mmvlasaty/HEHS_ROV_2018/README.md

# HEHS_ROV_2018

Control system repository for the HEHS 2018 MATE ROV competition team.
