mmvlasaty/HEHS_ROV_2018/Notes/Firmata.rtf

Instructions for modifying Firmata

Arduino Firmata Ethernet Setup

W5200 Drivers

https://github.com/Seeed-Studio/Ethernet_Shield_W5200

Remove Ethernet Directory from Arduino IDE Library.

Import W5200 Ethernet Drivers into Arduino IDE

Install Sample PrimaryFirmataEthernet

Save PrimaryFirmataEthernet sketch

Open ethernetConfig.h, add W5200 Library, comment out Ethernet.h line, change the remote IP to 192.168.0.xx (server’s IP address) and change local_IP to 192.168.0.177.

Navigate to Arduino/libraries/Firmata/Utility/EthernetServerStream.h and edit it with a text editor. When it opens, edit #include <Ethernet.h> to #include <EthernetV2_0.h> and save the file.

W5200 on Arduino

https://nathan.chantrell.net/20120811/using-the-atmega1284p-with-the-arduino-ide-wiz820io/

WIZ820IO needs a reset signal to be enabled by standalone atmega328p

From: https://forum.pjrc.com/threads/41958-Ethernet-begin-hangs-after-power-cyle-in-Nov-29-2016-release

Add the following before Ethernet.begin() in void initTransport() of StandardFirmataEthernet

pinMode(PIN_TO_DIGITAL(7), OUTPUT); // switch off SD card bypassing Firmata
digitalWrite(PIN_TO_DIGITAL(7), LOW); // WIZ820io RESET is active low;
delay(250); // need atleast 2us low
digitalWrite(PIN_TO_DIGITAL(7), HIGH); // Release WIZ820io Reset
delay(500); // need atleast 150ms low

Save the sketch, build and run.

BlueESC Python Control: https://www.youtube.com/watch?v=Ecfi71G2Hq4

https://www.dropbox.com/sh/btfzhd3q2ox37uf/AAB-JFvWSD_Um9bVl_S_k9vya?dl=0

USE I2C Scanner to find BlueESC addresses.

Explanation of using Pymata

http://www.instructables.com/id/Going-Beyond-StandardFirmata-Adding-New-Device-Sup/

Example code for controlling BlueESC over Ethernet

#!/usr/bin/python

from pymata_aio.pymata3 import PyMata3
from pymata_aio.constants import Constants

BOARD_LED = 8
board = PyMata3(ip_address = '192.168.0.177', ip_port=3030, ip_handshake='') # IP address of StandardFirmataEthernet and port

# I2c address of the motor controllers "0x29" = 41 is the default

DEVICE0_ADDRESS = 41
DEVICE1_ADDRESS = 42
DEVICE2_ADDRESS = 43

# I2c register of the throttle (it is 16 bit/2 byte so treat it like a "word")

THROTTLE0 = 6000 # max value = 32000
THROTTLE1 = 6000
THROTTLE2 = 6000

def setup():
# board.set_pin_mode(BOARD_LED, Constants.OUTPUT)

# configure firmata for i2c on an UNO

board.i2c_config(0)

def loop():
# print("LED On")

# board.digital_write(BOARD_LED, 1)

# board.sleep(1.0)

TEMP = 0x02
#The temperature's I2c register (it's 2 bytes 0x06 and 0x07)

# print("Is the BlueESC Alive?")

# print(board.i2c_read_request(DEVICE_ADDRESS, TEMP, 9, Constants.I2C_READ))

# print("Probably not in a real unit...")

# board.sleep(1.0)

print("initialize the motor")
board.i2c_write_request(DEVICE0_ADDRESS, [0, 0, 0]) #send 0, 0, 0 to arm the controller
board.i2c_write_request(DEVICE1_ADDRESS, [0, 0, 0])
board.i2c_write_request(DEVICE2_ADDRESS, [0, 0, 0])
board.sleep(2.0)
board.i2c_write_request(DEVICE0_ADDRESS, [0, -THROTTLE0>>8, -THROTTLE0]) #send (0, value>>8, value) to send (throttle command, high byte, low byte)
board.i2c_write_request(DEVICE1_ADDRESS, [0, -THROTTLE1>>8, -THROTTLE1])
board.i2c_write_request(DEVICE2_ADDRESS, [0, -THROTTLE2>>8, -THROTTLE2])
# board.i2c_write_request(DEVICE_ADDRESS, [0x00 | 0x00 | 0x00])

board.sleep(2.0)

print("turn on the motor forward")
board.i2c_write_request(DEVICE0_ADDRESS, [0, 0, 0])
board.i2c_write_request(DEVICE1_ADDRESS, [0, 0, 0])
board.i2c_write_request(DEVICE2_ADDRESS, [0, 0, 0])
board.sleep(2.0)
board.i2c_write_request(DEVICE0_ADDRESS, [0, THROTTLE0>>8, THROTTLE0])
board.i2c_write_request(DEVICE1_ADDRESS, [0, THROTTLE1>>8, THROTTLE1])
board.i2c_write_request(DEVICE2_ADDRESS, [0, THROTTLE2>>8, THROTTLE2])
board.sleep(2)

if __name__ == "__main__":
setup()
while True:
loop()

Add Ping to StandardFirmataEthernet

https://github.com/MrYsLab/pymata-aio/wiki/Uploading-FirmataPlus-to-Arduino

Copy all ping related code from Firmata plus found here: https://github.com/MrYsLab/pymata-aio/tree/master/FirmataPlus

Retrieve data from ping sensor: https://github.com/MrYsLab/pymata-aio/blob/master/test/ping.py
