mmvlasaty/HEHS_ROV_2018/(list of files, cad)

Other CAD files:
ATmega/tgy-bluesc/tp_nfet.obj
ATmega/tgy-bluesc/arctictiger.obj
ATmega/tgy-bluesc/tgy.obj
ATmega/tgy-bluesc/dlu40a.obj
ATmega/tgy-bluesc/tp_8khz.obj
ATmega/tgy-bluesc/hm135a.obj
ATmega/tgy-bluesc/afro2.obj
ATmega/tgy-bluesc/birdie70a.obj
ATmega/tgy-bluesc/bs_nfet.obj
ATmega/tgy-bluesc/tbs.obj
ATmega/tgy-bluesc/afro_nfet.obj
ATmega/tgy-bluesc/blueesc.obj
ATmega/tgy-bluesc/rct50a.obj
ATmega/tgy-bluesc/tgy6a.obj
ATmega/tgy-bluesc/afro.obj
ATmega/tgy-bluesc/bs.obj
ATmega/tgy-bluesc/bs40a.obj
ATmega/tgy-bluesc/rb70a.obj
ATmega/tgy-bluesc/rb50a.obj
ATmega/tgy-bluesc/tp70a.obj
ATmega/tgy-bluesc/mkblctrl1.obj
ATmega/tgy-bluesc/dlux.obj
ATmega/tgy-bluesc/hk200a.obj
ATmega/tgy-bluesc/tp.obj
ATmega/tgy-bluesc/kda.obj
ATmega/tgy-bluesc/afro_hv.obj
ATmega/tgy-bluesc/tp_i2c.obj
