mmvlasaty/HEHS_ROV_2018/ATmega/pymata-aio-master/examples/uno_iot_tester.html

- Digital Input
- Digital/PWM Output
- Analog Input
- Reports
- Polled Data Retrieval
- Servo
- i2c
- FirmataPlus Features

# PyMata IoT

You Are Not Connected To PyMata IoT

Disabled Enabled Pin 02: Data Latch Latch Event Occurred On:
Disabled Enabled Pin 03: Data Latch Latch Event Occurred On:
Disabled Enabled Pin 04: Data Latch Latch Event Occurred On:
Disabled Enabled Pin 05: Data Latch Latch Event Occurred On:
Disabled Enabled Pin 06: Data Latch Latch Event Occurred On:
Disabled Enabled Pin 07: Data Latch Latch Event Occurred On:
Disabled Enabled Pin 08: Data Latch Latch Event Occurred On:
Disabled Enabled Pin 09: Data Latch Latch Event Occurred On:
Disabled Enabled Pin 10: Data Latch Latch Event Occurred On:
Disabled Enabled Pin 11: Data Latch Latch Event Occurred On:
Disabled Enabled Pin 12: Data Latch Latch Event Occurred On:
Disabled Enabled Pin 13: Data Latch Latch Event Occurred On:
Disabled Enabled Pin 14: Data Latch Latch Event Occurred On:
Disabled Enabled Pin 15: Data Latch Latch Event Occurred On:
Disabled Enabled Pin 16: Data Latch Latch Event Occurred On:
Disabled Enabled Pin 17: Data Latch Latch Event Occurred On:
Disabled Enabled Pin 18: Data Latch Latch Event Occurred On:
Disabled Enabled Pin 19: Data Latch Latch Event Occurred On:

# PyMata IoT

Pin 02: Low High
Pin 03: Low High PWM
Pin 04: Low High
Pin 05: Low High PWM
Pin 06: Low High PWM
Pin 07: Low High
Pin 08: Low High
Pin 09: Low High PWM
Pin 10: Low High PWM
Pin 11: Low High PWM
Pin 12: Low High
Pin 13: Low High
Pin 14: Low High
Pin 15: Low High
Pin 16: Low High
Pin 17: Low High
Pin 18: Low High
Pin 19: Low High

# PyMata IoT

Disabled Enabled Pin A0: Latch Threshold Data Latch: Latch Event Occurred On:
Disabled Enabled Pin A1: Latch Threshold Data Latch: Latch Event Occurred On:
Disabled Enabled Pin A2: Latch Threshold Data Latch: Latch Event Occurred On:
Disabled Enabled Pin A3: Latch Threshold Data Latch: Latch Event Occurred On:
Disabled Enabled Pin A4: Latch Threshold Data Latch: Latch Event Occurred On:
Disabled Enabled Pin A5: Latch Threshold Data Latch: Latch Event Occurred On:

# PyMata IoT

(For Pin State Reports, first select the pin number by using the spinner and then click the button to the left)

# PyMata IoT

Digital Pin: Analog Pin:

Digital Latch Table Data:

Analog Latch Table Data:

# PyMata IoT

Servo Pin Servo Angle in Degress

# PyMata IoT

Default Values Are Set to Read Temperature from A Sparkfun TMP102 (https://www.sparkfun.com/products/11931)

## I2C Config (Use before an I2C read or write)

Read Delay Time

## I2C Read

Device Address Device Register Number of Bytes To Read Read Type

Celcius Fahrenheit

# PyMata IoT

Write Data To 8x8 BiColor LED Backpack Adafruit Product ID 109 (https://www.adafruit.com/products/902)

# PyMata IoT

## Tone

Pin: Frequency (Hz) Duration (ms)

## Encoder

Encoder Pin A: Encoder Pin B:

## Sonar

Trigger Pin: Echo Pin:

## Stepper

Pin 1: Pin 2: Pin 3: Pin 4: Steps/Rev (<= 21 bits)

Motor Speed (<= 21 bits) # Steps (<= 14 bits)
