mmvlasaty/HEHS_ROV_2018/Board/Eagle_Files/hawks_rov_1_controller_v2.pdf

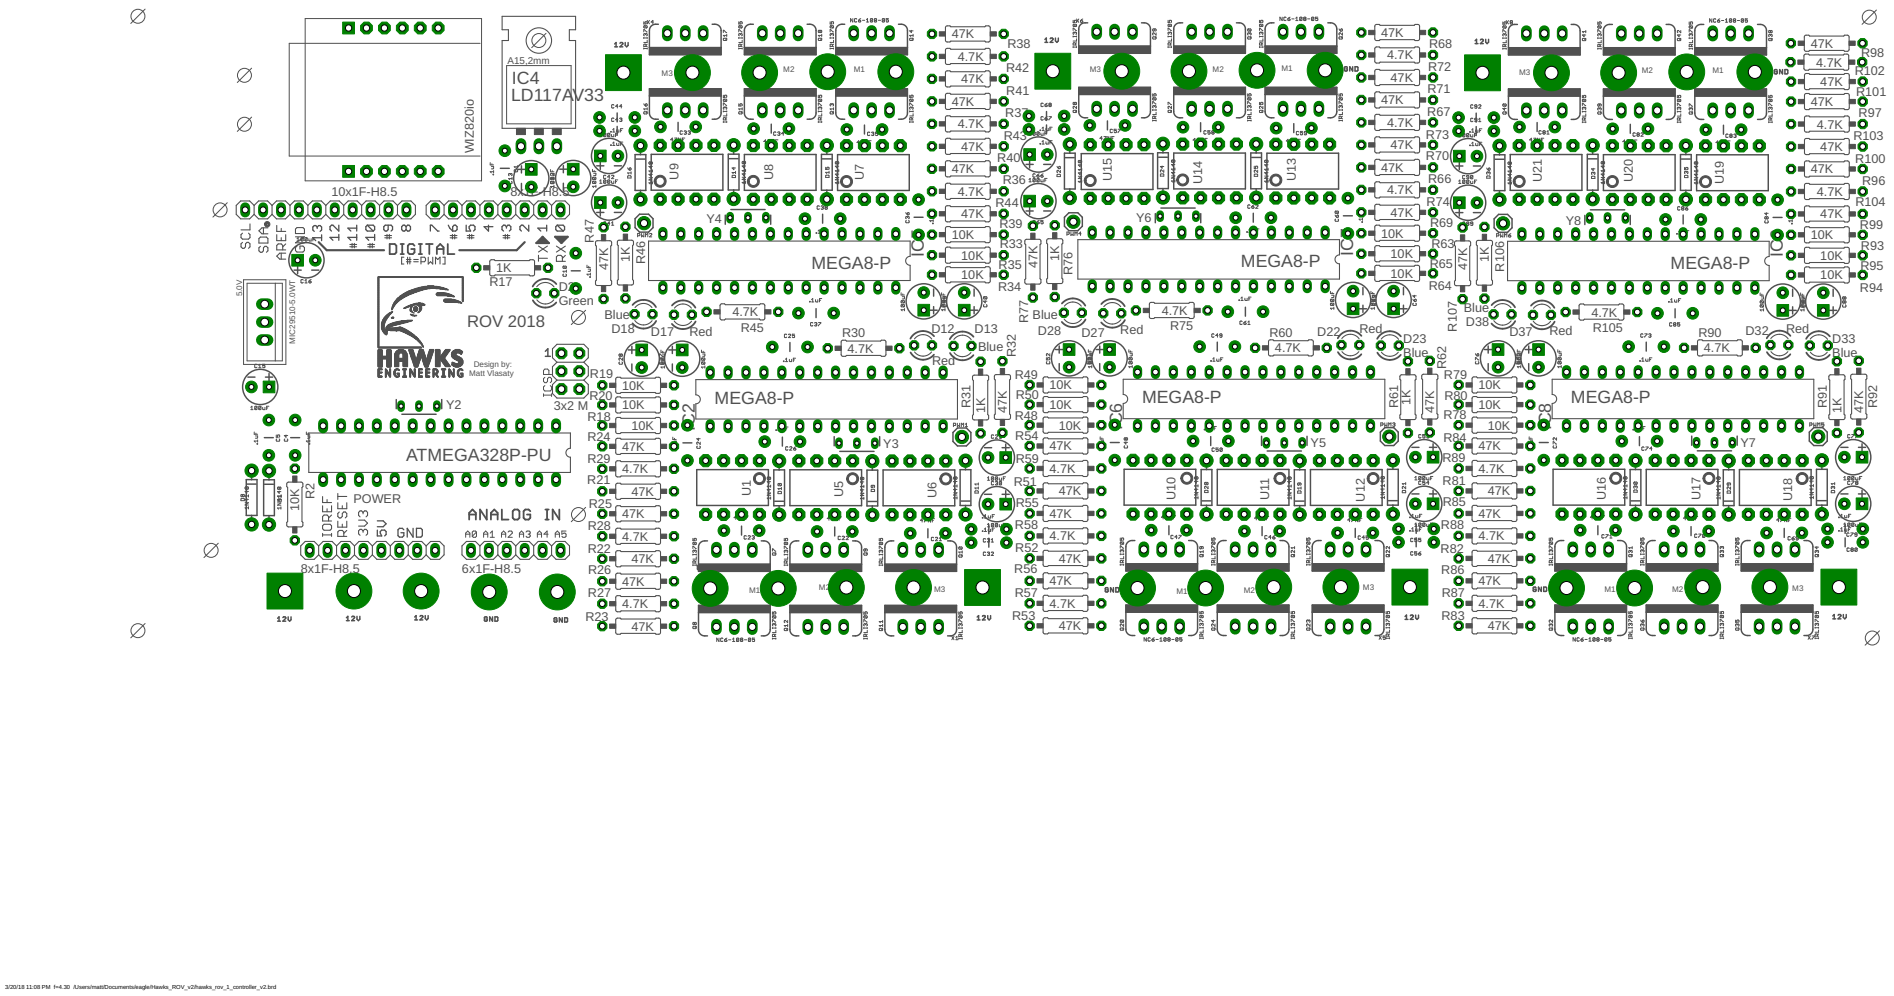
[picture p12: page 1]

3/20/18 11:08 PM f=4.30 /Users/matt/Documents/eagle/Hawks_ROV_v2/hawks_rov_1_controller_v2.brd
