mmvlasaty/HEHS_ROV_2018/Board/Eagle_Files/hawks_rov_1_controller_v2.brd

## EAGLE design Board/Eagle_Files/hawks_rov_1_controller_v2.brd (2018-12-30)

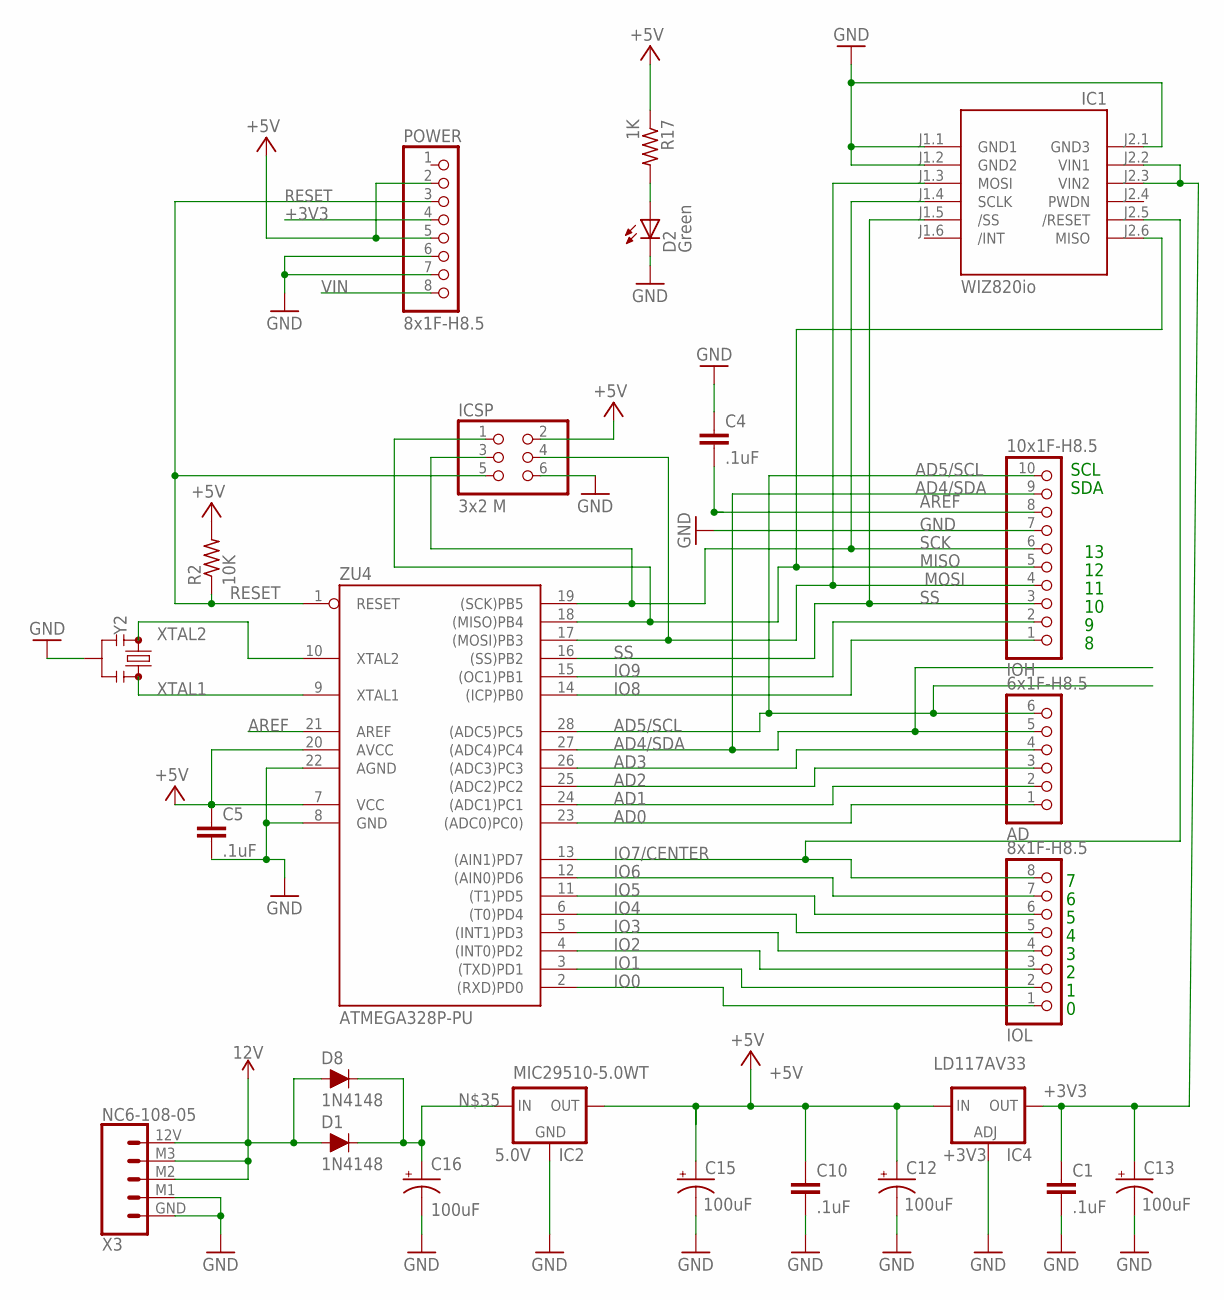
[picture p13: schematic hawks_rov_1_controller_v2.sch, sheet 1]

Parts:
AD: 6x1F-H8.5; 1X06
C1, C4, C5, C10: .1uF; CAP-PTH-5MM
C12, C13, C15, C16: 100uF; CPOL-RADIAL-2.5MM-5MM
D1, D8: 1N4148; DIODE-1N4148-KIT
D2: Green; LED3MM
IC1: WIZ820io; WIZ820IO
IC4: LD117AV33; TO220L1
ICSP: 3x2 M; 2X03
IOH: 10x1F-H8.5; 1X10
IOL: 8x1F-H8.5; 1X08
MIC29510-5.0WT: 5.0V; TO-220-STANDING
POWER: 8x1F-H8.5; 1X08
R2: 10K; 0207/10
R17: 1K; 0207/10
X3: NC6-108-05; SCREWTERMINAL-3.5MM-5
Y2: ZTT-16.00MX; SIP3-UA
ZU4: ATMEGA328P-PU; DIL28-3

Connections:
+3V3: C1.1, C13.1 (+), IC1.J2.2 (VIN1), IC1.J2.3 (VIN2), IC4.2 (OUT), POWER.4
+5V: C5.1, C10.1, C12.1 (+), C15.1 (+), IC4.3 (IN), ICSP.2, MIC29510-5.0WT.3 (OUT), POWER.2, POWER.5, R2.2, R17.1, ZU4.7 (VCC), ZU4.20 (AVCC); also elsewhere on the board
+12V: D1.A, D8.A, X3.12V (1), X3.M2 (3), X3.M3 (2)
AD0: AD.1, ZU4.23 ((ADC0)PC0))
AD1: AD.2, ZU4.24 ((ADC1)PC1)
AD2: AD.3, ZU4.25 ((ADC2)PC2)
AD3: AD.4, ZU4.26 ((ADC3)PC3)
AD4/SDA: AD.5, IOH.9, ZU4.27 ((ADC4)PC4); also elsewhere on the board
AD5/SCL: AD.6, IOH.10, ZU4.28 ((ADC5)PC5); also elsewhere on the board
AREF: C4.2, IOH.8, ZU4.21 (AREF)
GND: C1.2, C4.1, C5.2, C10.2, C12.2 (-), C13.2 (-), C15.2 (-), C16.2 (-), D2.K (C), IC1.J1.1 (GND1), IC1.J1.2 (GND2), IC1.J2.1 (GND3), IC4.1 (ADJ), ICSP.6, IOH.7, MIC29510-5.0WT.2 (GND), POWER.6, POWER.7, X3.GND (5), X3.M1 (4), Y2.2, ZU4.8 (GND), ZU4.22 (AGND); also elsewhere on the board
IO0: IOL.1, ZU4.2 ((RXD)PD0)
IO1: IOL.2, ZU4.3 ((TXD)PD1)
IO2: IOL.3, ZU4.4 ((INT0)PD2)
IO3: IOL.4, ZU4.5 ((INT1)PD3)
IO4: IOL.5, ZU4.6 ((T0)PD4)
IO5: IOL.6, ZU4.11 ((T1)PD5)
IO6: IOL.7, ZU4.12 ((AIN0)PD6)
IO7/CENTER: IC1.J2.5 (/RESET), IOL.8, ZU4.13 ((AIN1)PD7)
IO8: IOH.1, ZU4.14 ((ICP)PB0)
IO9: IOH.2, ZU4.15 ((OC1)PB1)
MISO: IC1.J2.6 (MISO), ICSP.1, IOH.5, ZU4.18 ((MISO)PB4)
MOSI: IC1.J1.3 (MOSI), ICSP.4, IOH.4, ZU4.17 ((MOSI)PB3)
unnamed: D2.A, R17.2
unnamed: C16.1 (+), D1.C, D8.C, MIC29510-5.0WT.1 (IN)
RESET: ICSP.5, POWER.3, R2.1, ZU4.1 (RESET)
SCK: IC1.J1.4 (SCLK), ICSP.3, IOH.6, ZU4.19 ((SCK)PB5)
SS: IC1.J1.5 (/SS), IOH.3, ZU4.16 ((SS)PB2)
VIN: POWER.8
XTAL1: Y2.3, ZU4.9 (XTAL1)
XTAL2: Y2.1, ZU4.10 (XTAL2)

Notes on the sheet:
SDA
SCL

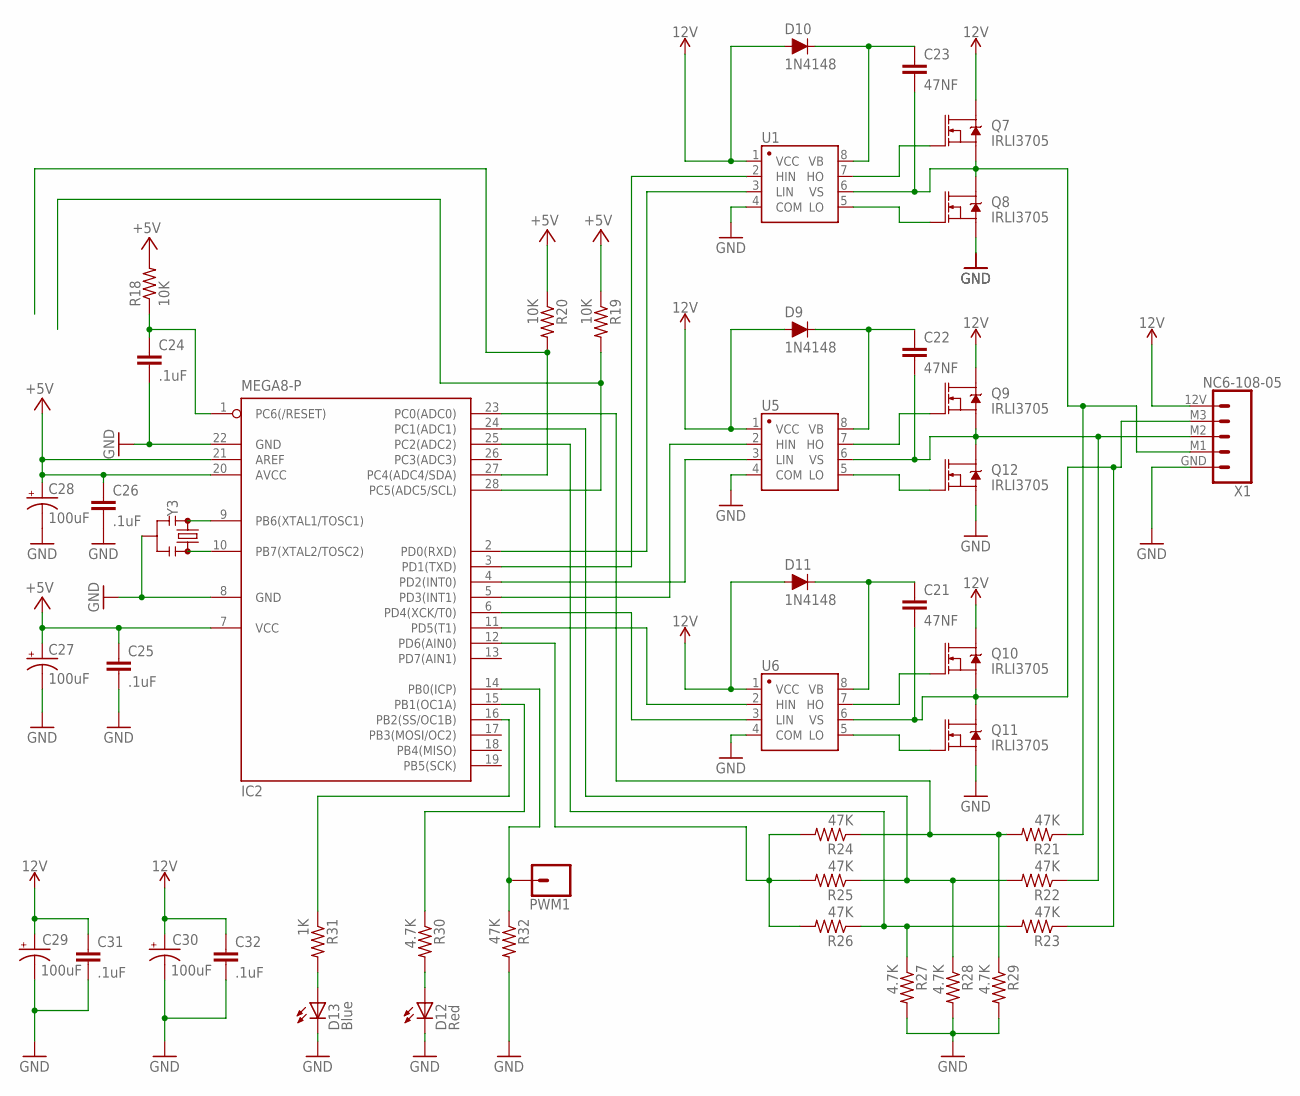
[picture p14: schematic hawks_rov_1_controller_v2.sch, sheet 2]

Parts:
C21, C22, C23: 47NF; CAP-PTH-5MM
C24, C25, C26, C31, C32: .1uF; CAP-PTH-5MM
C27, C28, C29, C30: 100uF; CPOL-RADIAL-2.5MM-5MM
D9, D10, D11: 1N4148; DIODE-1N4148-KIT
D12: Red; LED3MM
D13: Blue; LED3MM
IC2: MEGA8-P; DIL28-3
PWM1: CONN_01; 1X01
Q7, Q8, Q9, Q10, Q11, Q12: IRLI3705; TO220V
R18, R19, R20: 10K; 0207/10
R21, R22, R23, R24, R25, R26, R32: 47K; 0207/10
R27, R28, R29, R30: 4.7K; 0207/10
R31: 1K; 0207/10
U1, U5, U6: IR2101PBF; DIP-08
X1: NC6-108-05; SCREWTERMINAL-3.5MM-5
Y3: ZTT-16.00MX; SIP3-UA

Connections:
12V: C29.1 (+), C30.1 (+), C31.1, C32.1, D9.A, D10.A, D11.A, Q7.2 (D), Q9.2 (D), Q10.2 (D), U1.1 (VCC), U5.1 (VCC), U6.1 (VCC), X1.12V (1); also elsewhere on the board
+5V: C25.1, C26.1, C27.1 (+), C28.1 (+), IC2.7 (VCC), IC2.20 (AVCC), IC2.21 (AREF), R18.2, R19.1, R20.1; also elsewhere on the board
AD4/SDA: IC2.27 (PC4(ADC4/SDA)), R20.2; also elsewhere on the board
AD5/SCL: IC2.28 (PC5(ADC5/SCL)), R19.2; also elsewhere on the board
GND: C24.2, C25.2, C26.2, C27.2 (-), C28.2 (-), C29.2 (-), C30.2 (-), C31.2, C32.2, D12.K (C), D13.K (C), IC2.8 (GND), IC2.22 (GND), Q8.3 (S), Q11.3 (S), Q12.3 (S), R27.2, R28.2, R29.2, R32.2, U1.4 (COM), U5.4 (COM), U6.4 (COM), X1.GND (5), Y3.2; also elsewhere on the board
unnamed: IC2.3 (PD1(TXD)), U1.2 (HIN)
unnamed: IC2.2 (PD0(RXD)), U1.3 (LIN)
unnamed: IC2.5 (PD3(INT1)), U5.2 (HIN)
unnamed: IC2.4 (PD2(INT0)), U5.3 (LIN)
unnamed: IC2.11 (PD5(T1)), U6.2 (HIN)
unnamed: IC2.6 (PD4(XCK/T0)), U6.3 (LIN)
unnamed: Q7.1 (G), U1.7 (HO)
unnamed: Q8.1 (G), U1.5 (LO)
unnamed: Q9.1 (G), U5.7 (HO)
unnamed: Q12.1 (G), U5.5 (LO)
unnamed: Q10.1 (G), U6.7 (HO)
unnamed: Q11.1 (G), U6.5 (LO)
unnamed: C22.1, D9.C, U5.8 (VB)
unnamed: C23.1, D10.C, U1.8 (VB)
unnamed: C21.1, D11.C, U6.8 (VB)
unnamed: IC2.23 (PC0(ADC0)), R21.2, R24.1, R29.1
unnamed: IC2.24 (PC1(ADC1)), R22.2, R25.1, R28.1
unnamed: IC2.25 (PC2(ADC2)), R23.2, R26.1, R27.1
unnamed: C21.2, Q10.3 (S), Q11.2 (D), R23.1, U6.6 (VS), X1.M3 (2)
unnamed: C22.2, Q9.3 (S), Q12.2 (D), R22.1, U5.6 (VS), X1.M2 (3)
unnamed: C23.2, Q7.3 (S), Q8.2 (D), R21.1, U1.6 (VS), X1.M1 (4)
unnamed: IC2.12 (PD6(AIN0)), R24.2, R25.2, R26.2
unnamed: IC2.9 (PB6(XTAL1/TOSC1)), Y3.1
unnamed: IC2.10 (PB7(XTAL2/TOSC2)), Y3.3
unnamed: D12.A, R30.2
unnamed: D13.A, R31.2
unnamed: IC2.15 (PB1(OC1A)), R30.1
unnamed: IC2.16 (PB2(SS/OC1B)), R31.1
unnamed: C24.1, IC2.1 (PC6(/RESET)), R18.1
unnamed: IC2.14 (PB0(ICP)), PWM1.1, R32.1

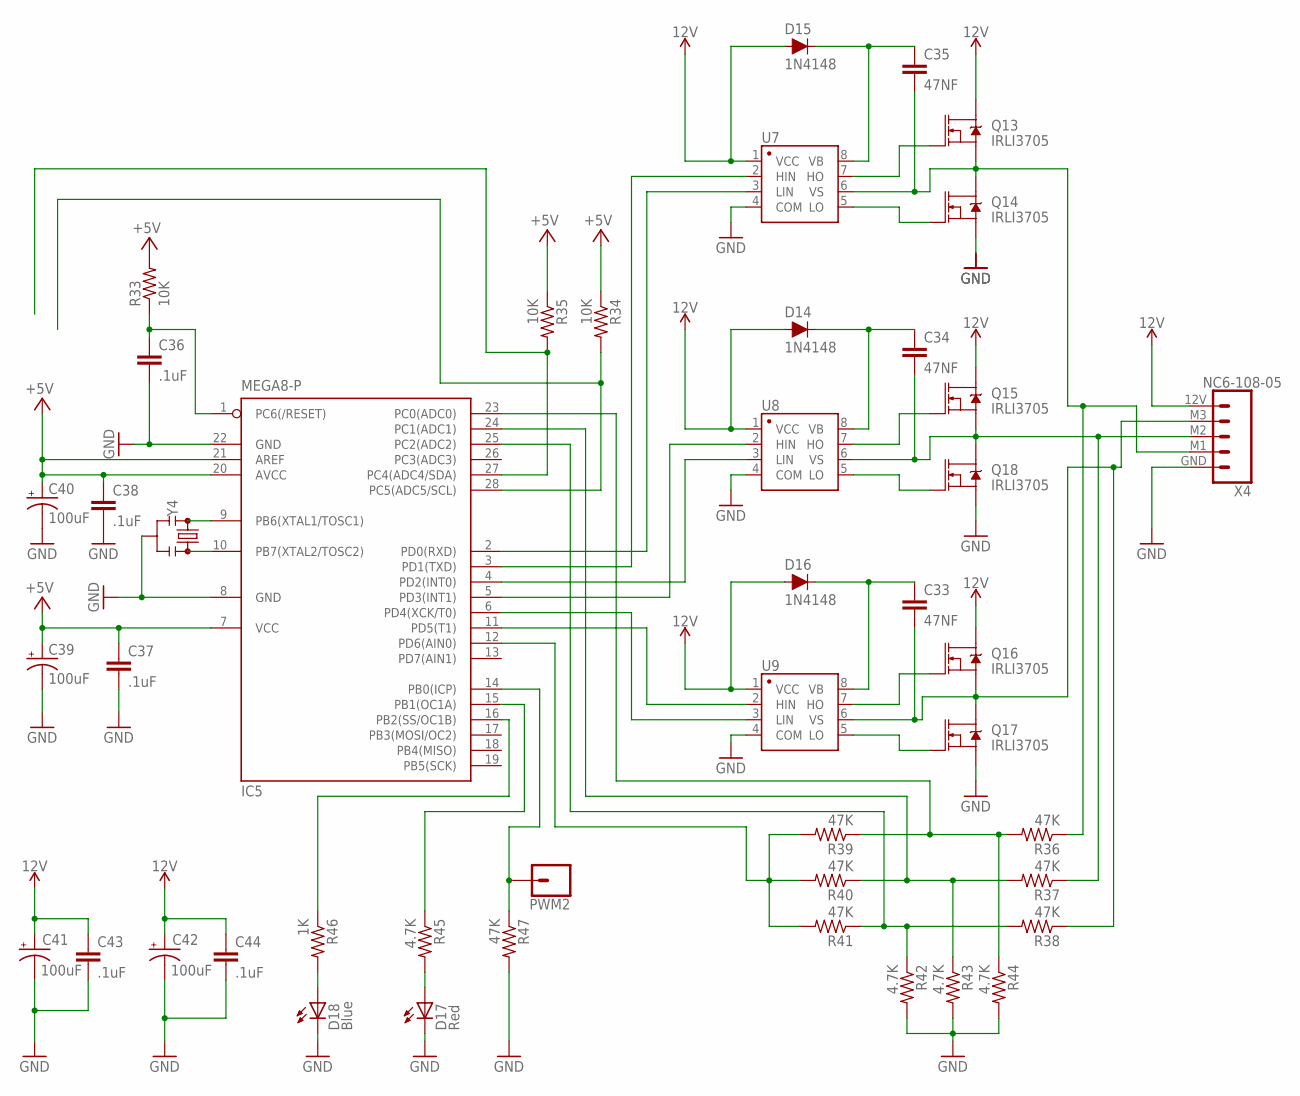
[picture p15: schematic hawks_rov_1_controller_v2.sch, sheet 3]

Parts:
C33, C34, C35: 47NF; CAP-PTH-5MM
C36, C37, C38, C43, C44: .1uF; CAP-PTH-5MM
C39, C40, C41, C42: 100uF; CPOL-RADIAL-2.5MM-5MM
D14, D15, D16: 1N4148; DIODE-1N4148-KIT
D17: Red; LED3MM
D18: Blue; LED3MM
IC5: MEGA8-P; DIL28-3
PWM2: CONN_01; 1X01
Q13, Q14, Q15, Q16, Q17, Q18: IRLI3705; TO220V
R33, R34, R35: 10K; 0207/10
R36, R37, R38, R39, R40, R41, R47: 47K; 0207/10
R42, R43, R44, R45: 4.7K; 0207/10
R46: 1K; 0207/10
U7, U8, U9: IR2101PBF; DIP-08
X4: NC6-108-05; SCREWTERMINAL-3.5MM-5
Y4: ZTT-16.00MX; SIP3-UA

Connections:
12V: C41.1 (+), C42.1 (+), C43.1, C44.1, D14.A, D15.A, D16.A, Q13.2 (D), Q15.2 (D), Q16.2 (D), U7.1 (VCC), U8.1 (VCC), U9.1 (VCC), X4.12V (1); also elsewhere on the board
+5V: C37.1, C38.1, C39.1 (+), C40.1 (+), IC5.7 (VCC), IC5.20 (AVCC), IC5.21 (AREF), R33.2, R34.1, R35.1; also elsewhere on the board
AD4/SDA: IC5.27 (PC4(ADC4/SDA)), R35.2; also elsewhere on the board
AD5/SCL: IC5.28 (PC5(ADC5/SCL)), R34.2; also elsewhere on the board
GND: C36.2, C37.2, C38.2, C39.2 (-), C40.2 (-), C41.2 (-), C42.2 (-), C43.2, C44.2, D17.K (C), D18.K (C), IC5.8 (GND), IC5.22 (GND), Q14.3 (S), Q17.3 (S), Q18.3 (S), R42.2, R43.2, R44.2, R47.2, U7.4 (COM), U8.4 (COM), U9.4 (COM), X4.GND (5), Y4.2; also elsewhere on the board
unnamed: IC5.3 (PD1(TXD)), U7.2 (HIN)
unnamed: IC5.2 (PD0(RXD)), U7.3 (LIN)
unnamed: IC5.5 (PD3(INT1)), U8.2 (HIN)
unnamed: IC5.4 (PD2(INT0)), U8.3 (LIN)
unnamed: IC5.11 (PD5(T1)), U9.2 (HIN)
unnamed: IC5.6 (PD4(XCK/T0)), U9.3 (LIN)
unnamed: Q13.1 (G), U7.7 (HO)
unnamed: Q14.1 (G), U7.5 (LO)
unnamed: Q15.1 (G), U8.7 (HO)
unnamed: Q18.1 (G), U8.5 (LO)
unnamed: Q16.1 (G), U9.7 (HO)
unnamed: Q17.1 (G), U9.5 (LO)
unnamed: C34.1, D14.C, U8.8 (VB)
unnamed: C35.1, D15.C, U7.8 (VB)
unnamed: C33.1, D16.C, U9.8 (VB)
unnamed: IC5.23 (PC0(ADC0)), R36.2, R39.1, R44.1
unnamed: IC5.24 (PC1(ADC1)), R37.2, R40.1, R43.1
unnamed: IC5.25 (PC2(ADC2)), R38.2, R41.1, R42.1
unnamed: C33.2, Q16.3 (S), Q17.2 (D), R38.1, U9.6 (VS), X4.M3 (2)
unnamed: C34.2, Q15.3 (S), Q18.2 (D), R37.1, U8.6 (VS), X4.M2 (3)
unnamed: C35.2, Q13.3 (S), Q14.2 (D), R36.1, U7.6 (VS), X4.M1 (4)
unnamed: IC5.12 (PD6(AIN0)), R39.2, R40.2, R41.2
unnamed: IC5.9 (PB6(XTAL1/TOSC1)), Y4.1
unnamed: IC5.10 (PB7(XTAL2/TOSC2)), Y4.3
unnamed: D17.A, R45.2
unnamed: D18.A, R46.2
unnamed: IC5.15 (PB1(OC1A)), R45.1
unnamed: IC5.16 (PB2(SS/OC1B)), R46.1
unnamed: C36.1, IC5.1 (PC6(/RESET)), R33.1
unnamed: IC5.14 (PB0(ICP)), PWM2.1, R47.1

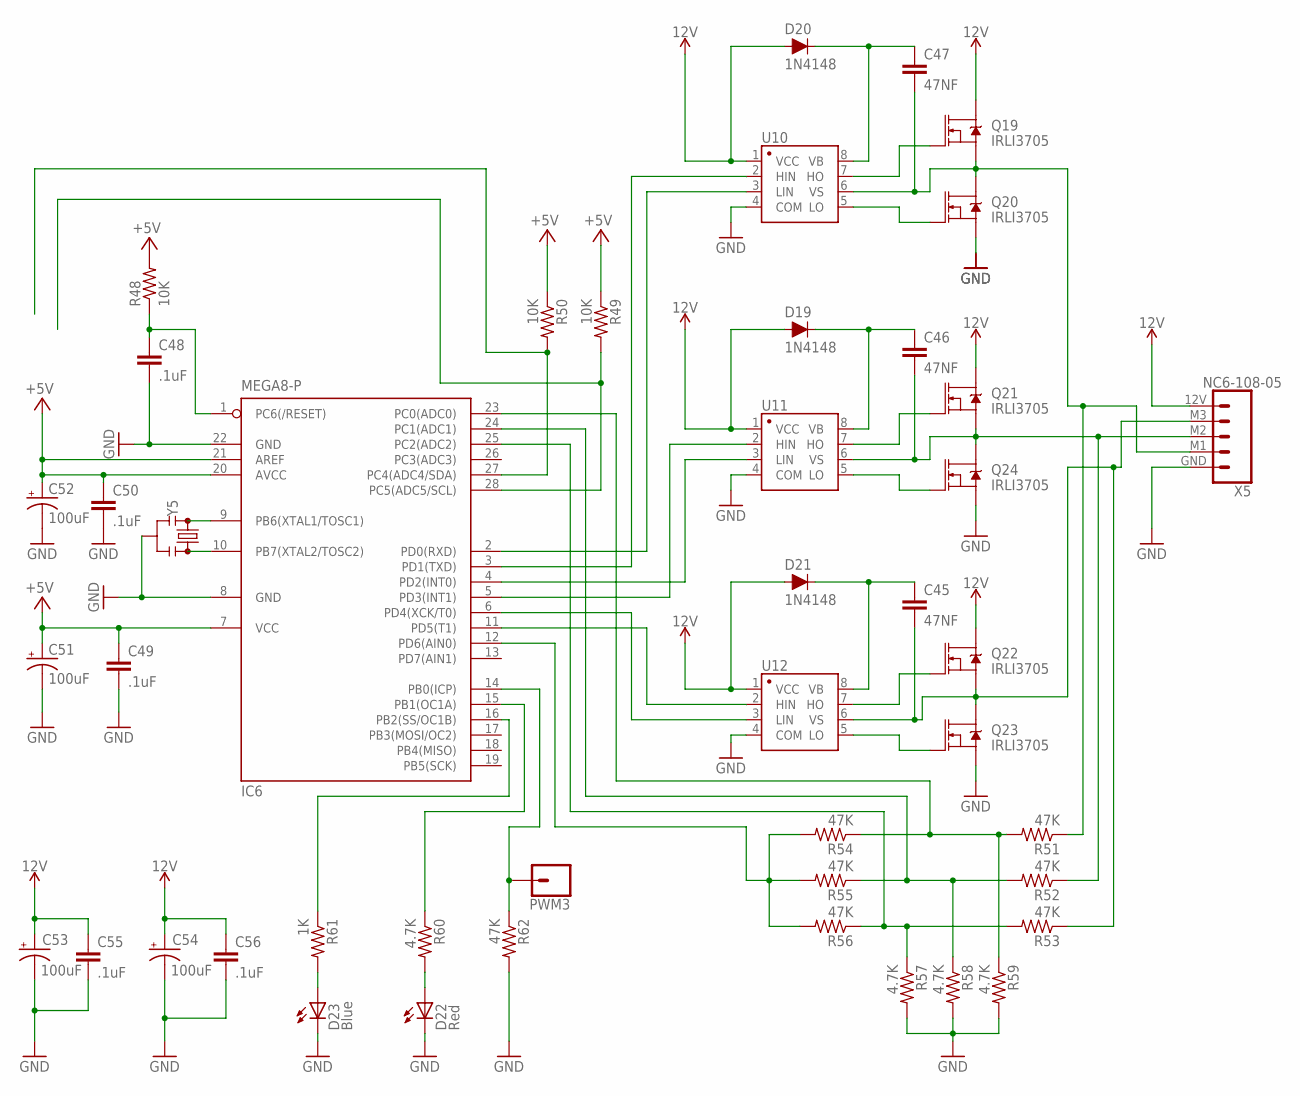
[picture p16: schematic hawks_rov_1_controller_v2.sch, sheet 4]

Parts:
C45, C46, C47: 47NF; CAP-PTH-5MM
C48, C49, C50, C55, C56: .1uF; CAP-PTH-5MM
C51, C52, C53, C54: 100uF; CPOL-RADIAL-2.5MM-5MM
D19, D20, D21: 1N4148; DIODE-1N4148-KIT
D22: Red; LED3MM
D23: Blue; LED3MM
IC6: MEGA8-P; DIL28-3
PWM3: CONN_01; 1X01
Q19, Q20, Q21, Q22, Q23, Q24: IRLI3705; TO220V
R48, R49, R50: 10K; 0207/10
R51, R52, R53, R54, R55, R56, R62: 47K; 0207/10
R57, R58, R59, R60: 4.7K; 0207/10
R61: 1K; 0207/10
U10, U11, U12: IR2101PBF; DIP-08
X5: NC6-108-05; SCREWTERMINAL-3.5MM-5
Y5: ZTT-16.00MX; SIP3-UA

Connections:
12V: C53.1 (+), C54.1 (+), C55.1, C56.1, D19.A, D20.A, D21.A, Q19.2 (D), Q21.2 (D), Q22.2 (D), U10.1 (VCC), U11.1 (VCC), U12.1 (VCC), X5.12V (1); also elsewhere on the board
+5V: C49.1, C50.1, C51.1 (+), C52.1 (+), IC6.7 (VCC), IC6.20 (AVCC), IC6.21 (AREF), R48.2, R49.1, R50.1; also elsewhere on the board
AD4/SDA: IC6.27 (PC4(ADC4/SDA)), R50.2; also elsewhere on the board
AD5/SCL: IC6.28 (PC5(ADC5/SCL)), R49.2; also elsewhere on the board
GND: C48.2, C49.2, C50.2, C51.2 (-), C52.2 (-), C53.2 (-), C54.2 (-), C55.2, C56.2, D22.K (C), D23.K (C), IC6.8 (GND), IC6.22 (GND), Q20.3 (S), Q23.3 (S), Q24.3 (S), R57.2, R58.2, R59.2, R62.2, U10.4 (COM), U11.4 (COM), U12.4 (COM), X5.GND (5), Y5.2; also elsewhere on the board
unnamed: IC6.3 (PD1(TXD)), U10.2 (HIN)
unnamed: IC6.2 (PD0(RXD)), U10.3 (LIN)
unnamed: IC6.5 (PD3(INT1)), U11.2 (HIN)
unnamed: IC6.4 (PD2(INT0)), U11.3 (LIN)
unnamed: IC6.11 (PD5(T1)), U12.2 (HIN)
unnamed: IC6.6 (PD4(XCK/T0)), U12.3 (LIN)
unnamed: Q19.1 (G), U10.7 (HO)
unnamed: Q20.1 (G), U10.5 (LO)
unnamed: Q21.1 (G), U11.7 (HO)
unnamed: Q24.1 (G), U11.5 (LO)
unnamed: Q22.1 (G), U12.7 (HO)
unnamed: Q23.1 (G), U12.5 (LO)
unnamed: C46.1, D19.C, U11.8 (VB)
unnamed: C47.1, D20.C, U10.8 (VB)
unnamed: C45.1, D21.C, U12.8 (VB)
unnamed: IC6.23 (PC0(ADC0)), R51.2, R54.1, R59.1
unnamed: IC6.24 (PC1(ADC1)), R52.2, R55.1, R58.1
unnamed: IC6.25 (PC2(ADC2)), R53.2, R56.1, R57.1
unnamed: C45.2, Q22.3 (S), Q23.2 (D), R53.1, U12.6 (VS), X5.M3 (2)
unnamed: C46.2, Q21.3 (S), Q24.2 (D), R52.1, U11.6 (VS), X5.M2 (3)
unnamed: C47.2, Q19.3 (S), Q20.2 (D), R51.1, U10.6 (VS), X5.M1 (4)
unnamed: IC6.12 (PD6(AIN0)), R54.2, R55.2, R56.2
unnamed: IC6.9 (PB6(XTAL1/TOSC1)), Y5.1
unnamed: IC6.10 (PB7(XTAL2/TOSC2)), Y5.3
unnamed: D22.A, R60.2
unnamed: D23.A, R61.2
unnamed: IC6.15 (PB1(OC1A)), R60.1
unnamed: IC6.16 (PB2(SS/OC1B)), R61.1
unnamed: C48.1, IC6.1 (PC6(/RESET)), R48.1
unnamed: IC6.14 (PB0(ICP)), PWM3.1, R62.1

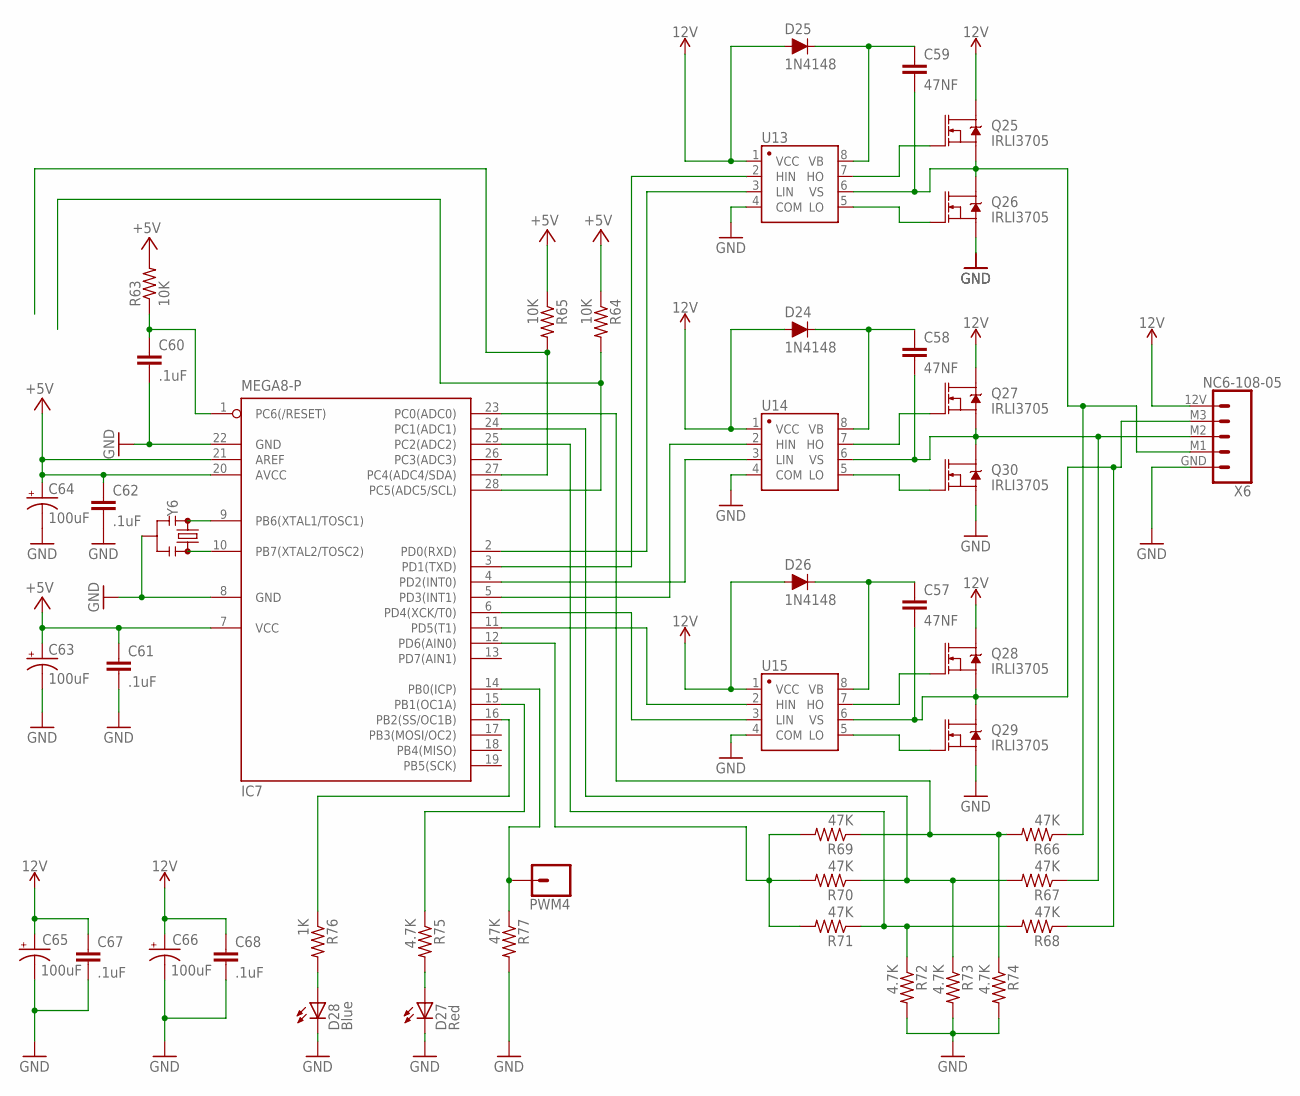
[picture p17: schematic hawks_rov_1_controller_v2.sch, sheet 5]

Parts:
C57, C58, C59: 47NF; CAP-PTH-5MM
C60, C61, C62, C67, C68: .1uF; CAP-PTH-5MM
C63, C64, C65, C66: 100uF; CPOL-RADIAL-2.5MM-5MM
D24, D25, D26: 1N4148; DIODE-1N4148-KIT
D27: Red; LED3MM
D28: Blue; LED3MM
IC7: MEGA8-P; DIL28-3
PWM4: CONN_01; 1X01
Q25, Q26, Q27, Q28, Q29, Q30: IRLI3705; TO220V
R63, R64, R65: 10K; 0207/10
R66, R67, R68, R69, R70, R71, R77: 47K; 0207/10
R72, R73, R74, R75: 4.7K; 0207/10
R76: 1K; 0207/10
U13, U14, U15: IR2101PBF; DIP-08
X6: NC6-108-05; SCREWTERMINAL-3.5MM-5
Y6: ZTT-16.00MX; SIP3-UA

Connections:
12V: C65.1 (+), C66.1 (+), C67.1, C68.1, D24.A, D25.A, D26.A, Q25.2 (D), Q27.2 (D), Q28.2 (D), U13.1 (VCC), U14.1 (VCC), U15.1 (VCC), X6.12V (1); also elsewhere on the board
+5V: C61.1, C62.1, C63.1 (+), C64.1 (+), IC7.7 (VCC), IC7.20 (AVCC), IC7.21 (AREF), R63.2, R64.1, R65.1; also elsewhere on the board
AD4/SDA: IC7.27 (PC4(ADC4/SDA)), R65.2; also elsewhere on the board
AD5/SCL: IC7.28 (PC5(ADC5/SCL)), R64.2; also elsewhere on the board
GND: C60.2, C61.2, C62.2, C63.2 (-), C64.2 (-), C65.2 (-), C66.2 (-), C67.2, C68.2, D27.K (C), D28.K (C), IC7.8 (GND), IC7.22 (GND), Q26.3 (S), Q29.3 (S), Q30.3 (S), R72.2, R73.2, R74.2, R77.2, U13.4 (COM), U14.4 (COM), U15.4 (COM), X6.GND (5), Y6.2; also elsewhere on the board
unnamed: IC7.3 (PD1(TXD)), U13.2 (HIN)
unnamed: IC7.2 (PD0(RXD)), U13.3 (LIN)
unnamed: IC7.5 (PD3(INT1)), U14.2 (HIN)
unnamed: IC7.4 (PD2(INT0)), U14.3 (LIN)
unnamed: IC7.11 (PD5(T1)), U15.2 (HIN)
unnamed: IC7.6 (PD4(XCK/T0)), U15.3 (LIN)
unnamed: Q25.1 (G), U13.7 (HO)
unnamed: Q26.1 (G), U13.5 (LO)
unnamed: Q27.1 (G), U14.7 (HO)
unnamed: Q30.1 (G), U14.5 (LO)
unnamed: Q28.1 (G), U15.7 (HO)
unnamed: Q29.1 (G), U15.5 (LO)
unnamed: C58.1, D24.C, U14.8 (VB)
unnamed: C59.1, D25.C, U13.8 (VB)
unnamed: C57.1, D26.C, U15.8 (VB)
unnamed: IC7.23 (PC0(ADC0)), R66.2, R69.1, R74.1
unnamed: IC7.24 (PC1(ADC1)), R67.2, R70.1, R73.1
unnamed: IC7.25 (PC2(ADC2)), R68.2, R71.1, R72.1
unnamed: C57.2, Q28.3 (S), Q29.2 (D), R68.1, U15.6 (VS), X6.M3 (2)
unnamed: C58.2, Q27.3 (S), Q30.2 (D), R67.1, U14.6 (VS), X6.M2 (3)
unnamed: C59.2, Q25.3 (S), Q26.2 (D), R66.1, U13.6 (VS), X6.M1 (4)
unnamed: IC7.12 (PD6(AIN0)), R69.2, R70.2, R71.2
unnamed: IC7.9 (PB6(XTAL1/TOSC1)), Y6.1
unnamed: IC7.10 (PB7(XTAL2/TOSC2)), Y6.3
unnamed: D27.A, R75.2
unnamed: D28.A, R76.2
unnamed: IC7.15 (PB1(OC1A)), R75.1
unnamed: IC7.16 (PB2(SS/OC1B)), R76.1
unnamed: C60.1, IC7.1 (PC6(/RESET)), R63.1
unnamed: IC7.14 (PB0(ICP)), PWM4.1, R77.1

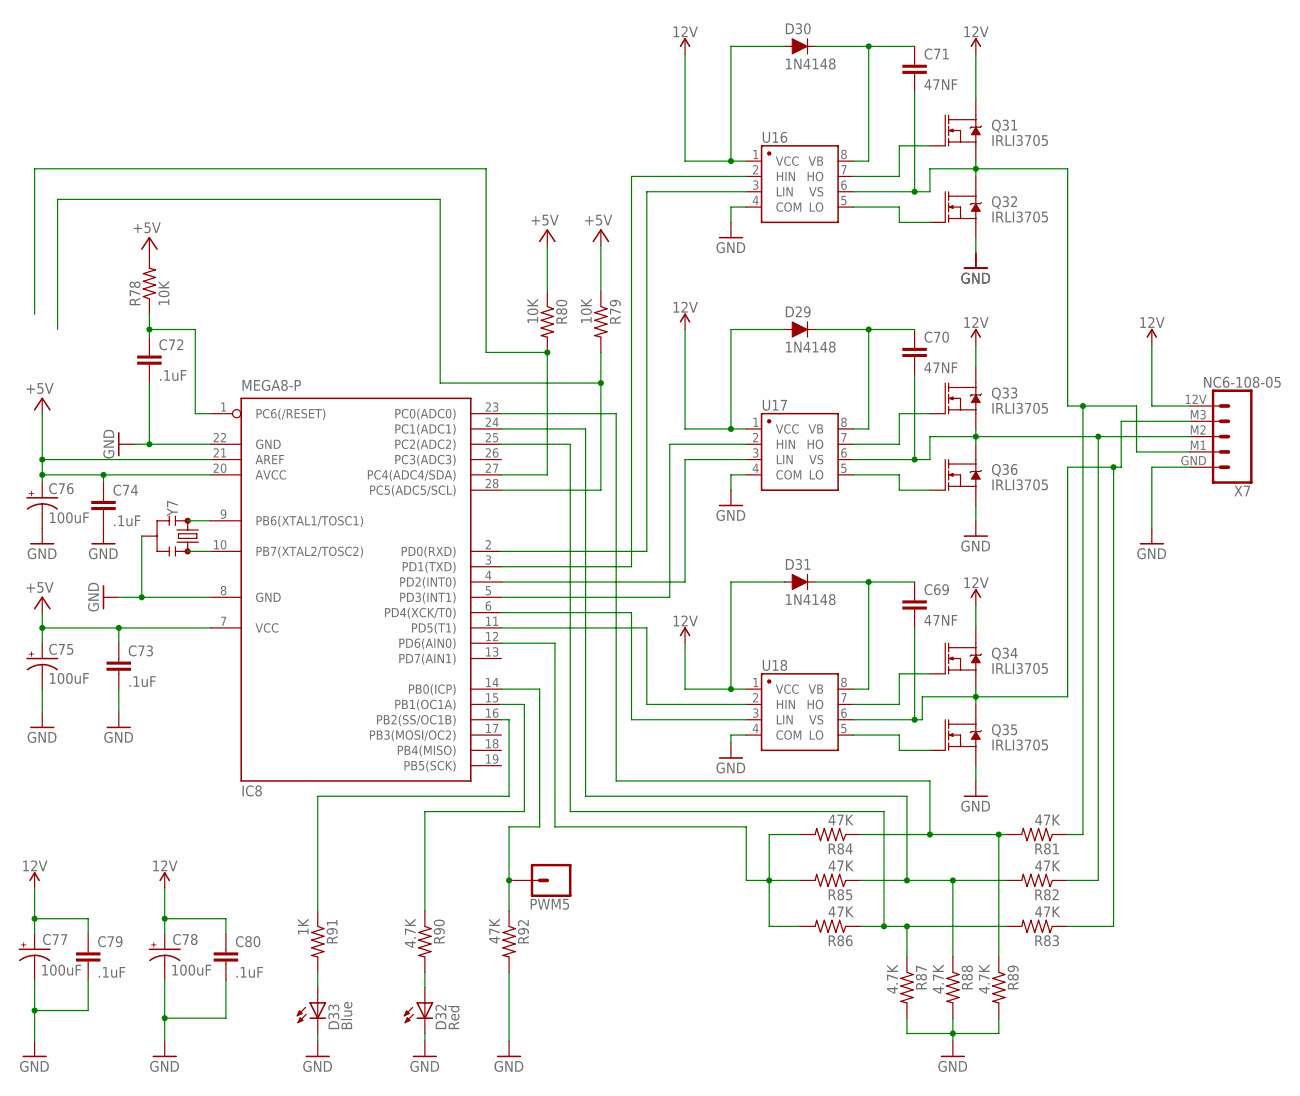
[picture p18: schematic hawks_rov_1_controller_v2.sch, sheet 6]

Parts:
C69, C70, C71: 47NF; CAP-PTH-5MM
C72, C73, C74, C79, C80: .1uF; CAP-PTH-5MM
C75, C76, C77, C78: 100uF; CPOL-RADIAL-2.5MM-5MM
D29, D30, D31: 1N4148; DIODE-1N4148-KIT
D32: Red; LED3MM
D33: Blue; LED3MM
IC8: MEGA8-P; DIL28-3
PWM5: CONN_01; 1X01
Q31, Q32, Q33, Q34, Q35, Q36: IRLI3705; TO220V
R78, R79, R80: 10K; 0207/10
R81, R82, R83, R84, R85, R86, R92: 47K; 0207/10
R87, R88, R89, R90: 4.7K; 0207/10
R91: 1K; 0207/10
U16, U17, U18: IR2101PBF; DIP-08
X7: NC6-108-05; SCREWTERMINAL-3.5MM-5
Y7: ZTT-16.00MX; SIP3-UA

Connections:
12V: C77.1 (+), C78.1 (+), C79.1, C80.1, D29.A, D30.A, D31.A, Q31.2 (D), Q33.2 (D), Q34.2 (D), U16.1 (VCC), U17.1 (VCC), U18.1 (VCC), X7.12V (1); also elsewhere on the board
+5V: C73.1, C74.1, C75.1 (+), C76.1 (+), IC8.7 (VCC), IC8.20 (AVCC), IC8.21 (AREF), R78.2, R79.1, R80.1; also elsewhere on the board
AD4/SDA: IC8.27 (PC4(ADC4/SDA)), R80.2; also elsewhere on the board
AD5/SCL: IC8.28 (PC5(ADC5/SCL)), R79.2; also elsewhere on the board
GND: C72.2, C73.2, C74.2, C75.2 (-), C76.2 (-), C77.2 (-), C78.2 (-), C79.2, C80.2, D32.K (C), D33.K (C), IC8.8 (GND), IC8.22 (GND), Q32.3 (S), Q35.3 (S), Q36.3 (S), R87.2, R88.2, R89.2, R92.2, U16.4 (COM), U17.4 (COM), U18.4 (COM), X7.GND (5), Y7.2; also elsewhere on the board
unnamed: IC8.3 (PD1(TXD)), U16.2 (HIN)
unnamed: IC8.2 (PD0(RXD)), U16.3 (LIN)
unnamed: IC8.5 (PD3(INT1)), U17.2 (HIN)
unnamed: IC8.4 (PD2(INT0)), U17.3 (LIN)
unnamed: IC8.11 (PD5(T1)), U18.2 (HIN)
unnamed: IC8.6 (PD4(XCK/T0)), U18.3 (LIN)
unnamed: Q31.1 (G), U16.7 (HO)
unnamed: Q32.1 (G), U16.5 (LO)
unnamed: Q33.1 (G), U17.7 (HO)
unnamed: Q36.1 (G), U17.5 (LO)
unnamed: Q34.1 (G), U18.7 (HO)
unnamed: Q35.1 (G), U18.5 (LO)
unnamed: C70.1, D29.C, U17.8 (VB)
unnamed: C71.1, D30.C, U16.8 (VB)
unnamed: C69.1, D31.C, U18.8 (VB)
unnamed: IC8.23 (PC0(ADC0)), R81.2, R84.1, R89.1
unnamed: IC8.24 (PC1(ADC1)), R82.2, R85.1, R88.1
unnamed: IC8.25 (PC2(ADC2)), R83.2, R86.1, R87.1
unnamed: C69.2, Q34.3 (S), Q35.2 (D), R83.1, U18.6 (VS), X7.M3 (2)
unnamed: C70.2, Q33.3 (S), Q36.2 (D), R82.1, U17.6 (VS), X7.M2 (3)
unnamed: C71.2, Q31.3 (S), Q32.2 (D), R81.1, U16.6 (VS), X7.M1 (4)
unnamed: IC8.12 (PD6(AIN0)), R84.2, R85.2, R86.2
unnamed: IC8.9 (PB6(XTAL1/TOSC1)), Y7.1
unnamed: IC8.10 (PB7(XTAL2/TOSC2)), Y7.3
unnamed: D32.A, R90.2
unnamed: D33.A, R91.2
unnamed: IC8.15 (PB1(OC1A)), R90.1
unnamed: IC8.16 (PB2(SS/OC1B)), R91.1
unnamed: C72.1, IC8.1 (PC6(/RESET)), R78.1
unnamed: IC8.14 (PB0(ICP)), PWM5.1, R92.1

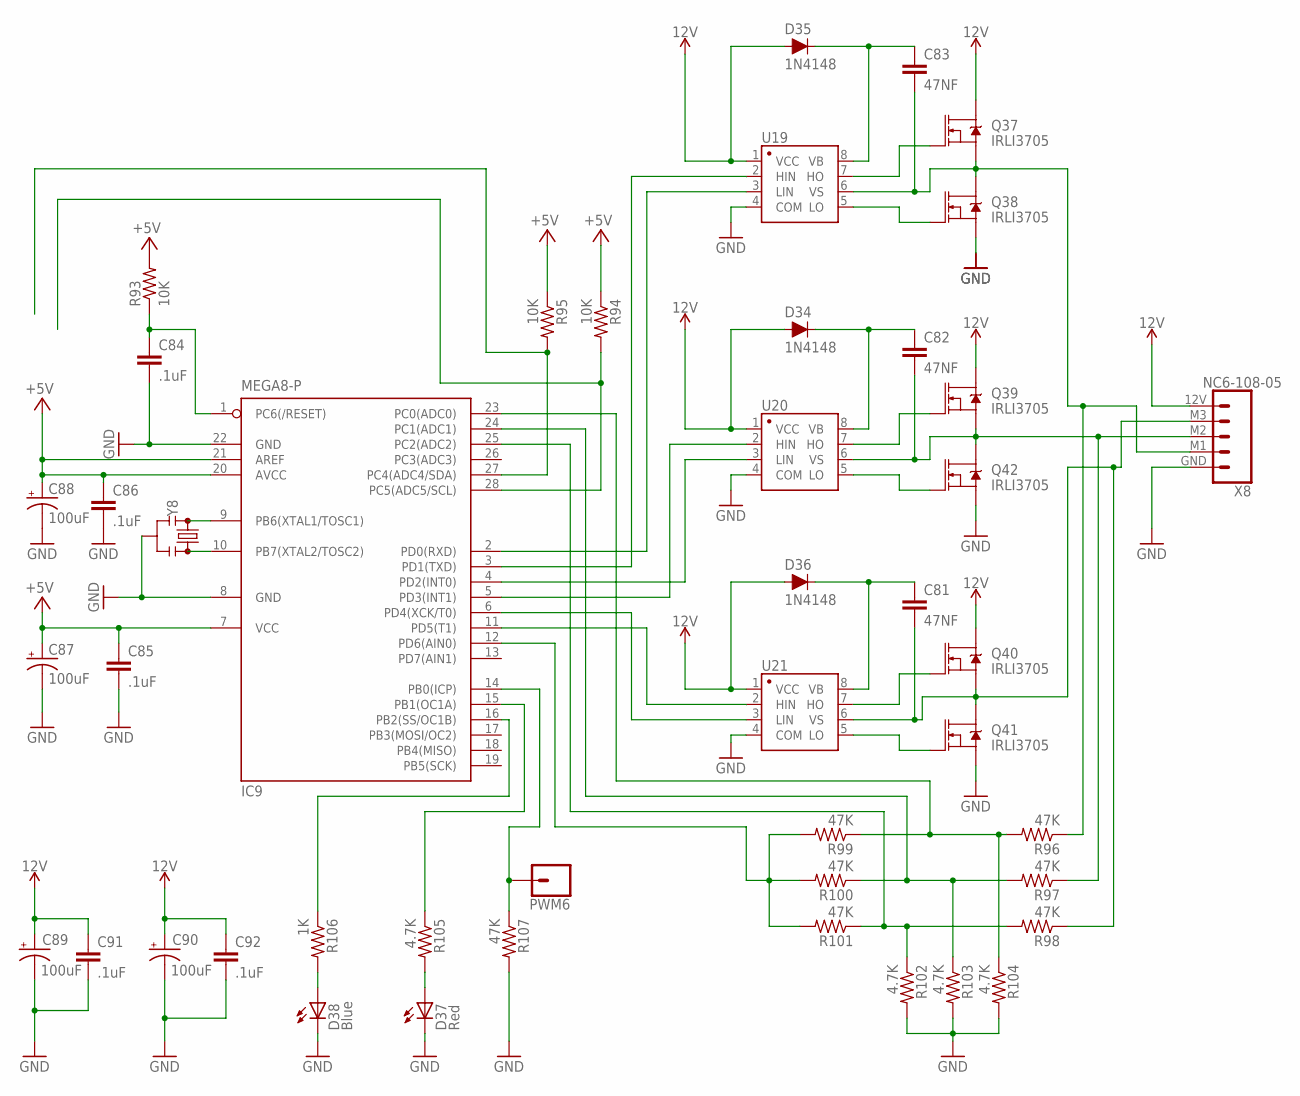
[picture p19: schematic hawks_rov_1_controller_v2.sch, sheet 7]

Parts:
C81, C82, C83: 47NF; CAP-PTH-5MM
C84, C85, C86, C91, C92: .1uF; CAP-PTH-5MM
C87, C88, C89, C90: 100uF; CPOL-RADIAL-2.5MM-5MM
D34, D35, D36: 1N4148; DIODE-1N4148-KIT
D37: Red; LED3MM
D38: Blue; LED3MM
IC9: MEGA8-P; DIL28-3
PWM6: CONN_01; 1X01
Q37, Q38, Q39, Q40, Q41, Q42: IRLI3705; TO220V
R93, R94, R95: 10K; 0207/10
R96, R97, R98, R99, R100, R101, R107: 47K; 0207/10
R102, R103, R104, R105: 4.7K; 0207/10
R106: 1K; 0207/10
U19, U20, U21: IR2101PBF; DIP-08
X8: NC6-108-05; SCREWTERMINAL-3.5MM-5
Y8: ZTT-16.00MX; SIP3-UA

Connections:
12V: C89.1 (+), C90.1 (+), C91.1, C92.1, D34.A, D35.A, D36.A, Q37.2 (D), Q39.2 (D), Q40.2 (D), U19.1 (VCC), U20.1 (VCC), U21.1 (VCC), X8.12V (1); also elsewhere on the board
+5V: C85.1, C86.1, C87.1 (+), C88.1 (+), IC9.7 (VCC), IC9.20 (AVCC), IC9.21 (AREF), R93.2, R94.1, R95.1; also elsewhere on the board
AD4/SDA: IC9.27 (PC4(ADC4/SDA)), R95.2; also elsewhere on the board
AD5/SCL: IC9.28 (PC5(ADC5/SCL)), R94.2; also elsewhere on the board
GND: C84.2, C85.2, C86.2, C87.2 (-), C88.2 (-), C89.2 (-), C90.2 (-), C91.2, C92.2, D37.K (C), D38.K (C), IC9.8 (GND), IC9.22 (GND), Q38.3 (S), Q41.3 (S), Q42.3 (S), R102.2, R103.2, R104.2, R107.2, U19.4 (COM), U20.4 (COM), U21.4 (COM), X8.GND (5), Y8.2; also elsewhere on the board
unnamed: IC9.3 (PD1(TXD)), U19.2 (HIN)
unnamed: IC9.2 (PD0(RXD)), U19.3 (LIN)
unnamed: IC9.5 (PD3(INT1)), U20.2 (HIN)
unnamed: IC9.4 (PD2(INT0)), U20.3 (LIN)
unnamed: IC9.11 (PD5(T1)), U21.2 (HIN)
unnamed: IC9.6 (PD4(XCK/T0)), U21.3 (LIN)
unnamed: Q37.1 (G), U19.7 (HO)
unnamed: Q38.1 (G), U19.5 (LO)
unnamed: Q39.1 (G), U20.7 (HO)
unnamed: Q42.1 (G), U20.5 (LO)
unnamed: Q40.1 (G), U21.7 (HO)
unnamed: Q41.1 (G), U21.5 (LO)
unnamed: C82.1, D34.C, U20.8 (VB)
unnamed: C83.1, D35.C, U19.8 (VB)
unnamed: C81.1, D36.C, U21.8 (VB)
unnamed: IC9.23 (PC0(ADC0)), R96.2, R99.1, R104.1
unnamed: IC9.24 (PC1(ADC1)), R97.2, R100.1, R103.1
unnamed: IC9.25 (PC2(ADC2)), R98.2, R101.1, R102.1
unnamed: C81.2, Q40.3 (S), Q41.2 (D), R98.1, U21.6 (VS), X8.M3 (2)
unnamed: C82.2, Q39.3 (S), Q42.2 (D), R97.1, U20.6 (VS), X8.M2 (3)
unnamed: C83.2, Q37.3 (S), Q38.2 (D), R96.1, U19.6 (VS), X8.M1 (4)
unnamed: IC9.12 (PD6(AIN0)), R99.2, R100.2, R101.2
unnamed: IC9.9 (PB6(XTAL1/TOSC1)), Y8.1
unnamed: IC9.10 (PB7(XTAL2/TOSC2)), Y8.3
unnamed: D37.A, R105.2
unnamed: D38.A, R106.2
unnamed: IC9.15 (PB1(OC1A)), R105.1
unnamed: IC9.16 (PB2(SS/OC1B)), R106.1
unnamed: C84.1, IC9.1 (PC6(/RESET)), R93.1
unnamed: IC9.14 (PB0(ICP)), PWM6.1, R107.1

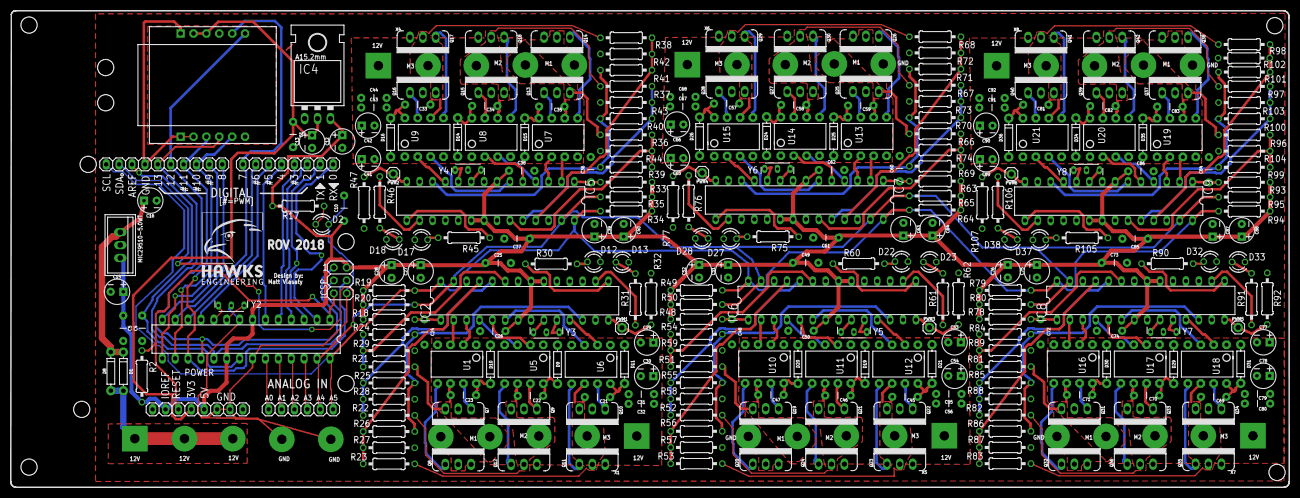
[picture p20: board hawks_rov_1_controller_v2.brd from above]

Board: 2 copper layers, 251.8 x 93.9 mm, 295 parts (1 on the bottom side), 211 nets.

Other parts of the board:
U$1: IMAGE1#JPEG
