mmvlasaty/HEHS_ROV_2018/(commit log)

2018-12-30 Added board folder
    [hawks_rov_1_controller_v2.brd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]
2018-12-30 Added ESC firmware
2018-12-30 Stopped ignoring .hex and .obj files
    [afro.obj, afro2.obj, afro_hv.obj, afro_nfet.obj, arctictiger.obj, birdie70a.obj, blueesc.obj, bs.obj]
2018-12-30 Added ESC instructions
2018-12-30 PDF for ESC
